gabebuckmaster/Si4825-AM-FM-Radio-Kit-SMT/README.md

# Si4825-AM-FM-Radio-Kit-SMT
Si4825 AM/FM Radio Kit (SMT)
