gabebuckmaster/Si4825-AM-FM-Radio-Kit-SMT/Si4825_KIT_SMT_pcb_preview_top.png

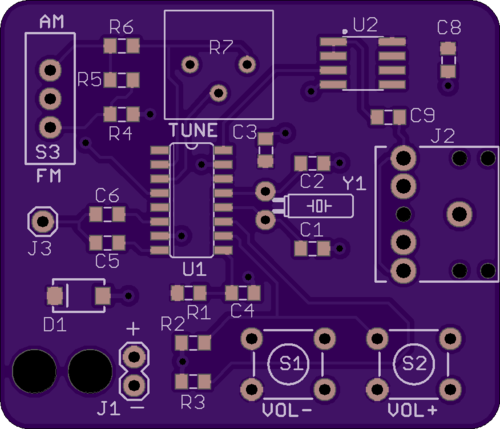
Si4825_KIT_SMT_pcb_preview_top.png
