gabebuckmaster/Si4825-AM-FM-Radio-Kit-SMT/SI4825_KIT_SMT_BOM.xlsx

Ref Des | Description | Manufacturer | MPN | Qty | Price at Qty*20 | Link | Alternate
C1, C2 | 22pF 0805 C0G Capacitor | Kemet | C0805C220J5GACTU | 2 | 0.048 | http://www.digikey.com/product-detail/en/kemet/C0805C220J5GACTU/399-1113-1-ND/411388
C3-C6, C8 | 1uF 0805 X7R Capacitor | Yageo | CC0805KKX7R7BB105 | 5 | 0.069 | http://www.digikey.com/product-detail/en/yageo/CC0805KKX7R7BB105/311-1365-1-ND/2103149
C9 | 22uF 0805 X6S Capacitor | Murata | GRM21BC80G226ME39L | 1 | 0.14 | http://www.digikey.com/product-detail/en/murata-electronics-north-america/GRM21BC80G226ME39L/490-6464-1-ND/3845661
D1 | 1A SMA General Purpose Diode | Diodes Incorporated | S1A-13-F | 1 | 0.199 | http://www.digikey.com/product-detail/en/diodes-incorporated/S1A-13-F/S1A-FDICT-ND/750031
J1 | Connection point for battery pack |  |  | 0
J2 | Headphone Jack | CUI Inc | SJ1-3523NG | 1 | 0.808 | http://www.digikey.com/product-search/en?keywords=SJ1-3523NG
J3 | Antenna connection point |  |  | 0
R1-R3 | 100kOhm 1% 0805 Resistor | Any |  | 3 | 0.0084 | http://www.digikey.com/product-detail/en/yageo/RC0805FR-07100KL/311-100KCRCT-ND/730491
R4 | 76.8kOhm 1% 0805 Resistor | Any |  | 1 | 0.021 | http://www.digikey.com/product-detail/en/yageo/RC0805FR-0776K8L/311-76.8KCRCT-ND/731084
R5 | 150kOhm 1% 0805 Resistor | Any |  | 1 | 0.021 | http://www.digikey.com/product-detail/en/yageo/RC0805FR-07150KL/311-150KCRCT-ND/730561
R6 | 273kOhm 1% 0805 Resistor | Any |  | 1 | 0.021 | http://www.digikey.com/product-detail/en/yageo/RC0805FR-07274KL/311-274KCRCT-ND/730733
R7 | 100kOhm Potentiometer | Bourns | 3386P-1-104TLF | 1 | 2.175 | http://www.digikey.com/product-search/en?keywords=3386P-1-104TLF
R8 | 0805 Jumper | Any |  | NOSTUFF | 0.018 | http://www.digikey.com/product-detail/en/yageo/RC0805JR-070RL/311-0.0ARCT-ND/731163
S1, S2 | Momentary Pushbutton Switch - NO | TE Connectivity | 1825910-6 | 2 | 0.088 | http://www.digikey.com/product-detail/en/te-connectivity-alcoswitch-switches/1825910-6/450-1650-ND/1632536
S3 | SPDT switch | E-Switch | EG1218 | 1 | 0.559 | http://www.digikey.com/product-detail/en/e-switch/EG1218/EG1903-ND/101726
U1 | Multi-band Radio Receiver IC | SiLabs | SI4825-A10-CS | 1 | ? | ?
U2 | Dual low-voltage op amp | Microchip | MCP6002T-I/SN | 1 | 0.33 | http://www.digikey.com/product-detail/en/microchip-technology/MCP6002T-I-SN/MCP6002T-I-SNDKR-ND/4307917
Y1 | 32.768 kHz Crystal (cylindrical can, radial) | Citizen Finedevice Co Ltd | CFS-20632768DZBB | 1 | 0.2 | http://www.digikey.com/product-detail/en/citizen-finedevice-co-ltd/CFS-20632768DZBB/300-8301-ND/862578
XX | Battery holder with switch | Memory Protection Devices | SBH321AS | 1 | 2.14 | http://www.digikey.com/product-detail/en/mpd-memory-protection-devices/SBH321AS/SBH321AS-ND/275301 | http://www.digikey.com/product-search/en?keywords=SBH421AS-ND
XX | SI4825 Surface Mount KIT PCB
