gabebuckmaster/Si4825-AM-FM-Radio-Kit-SMT/Si4825_KIT_SMT_schematic.pdf

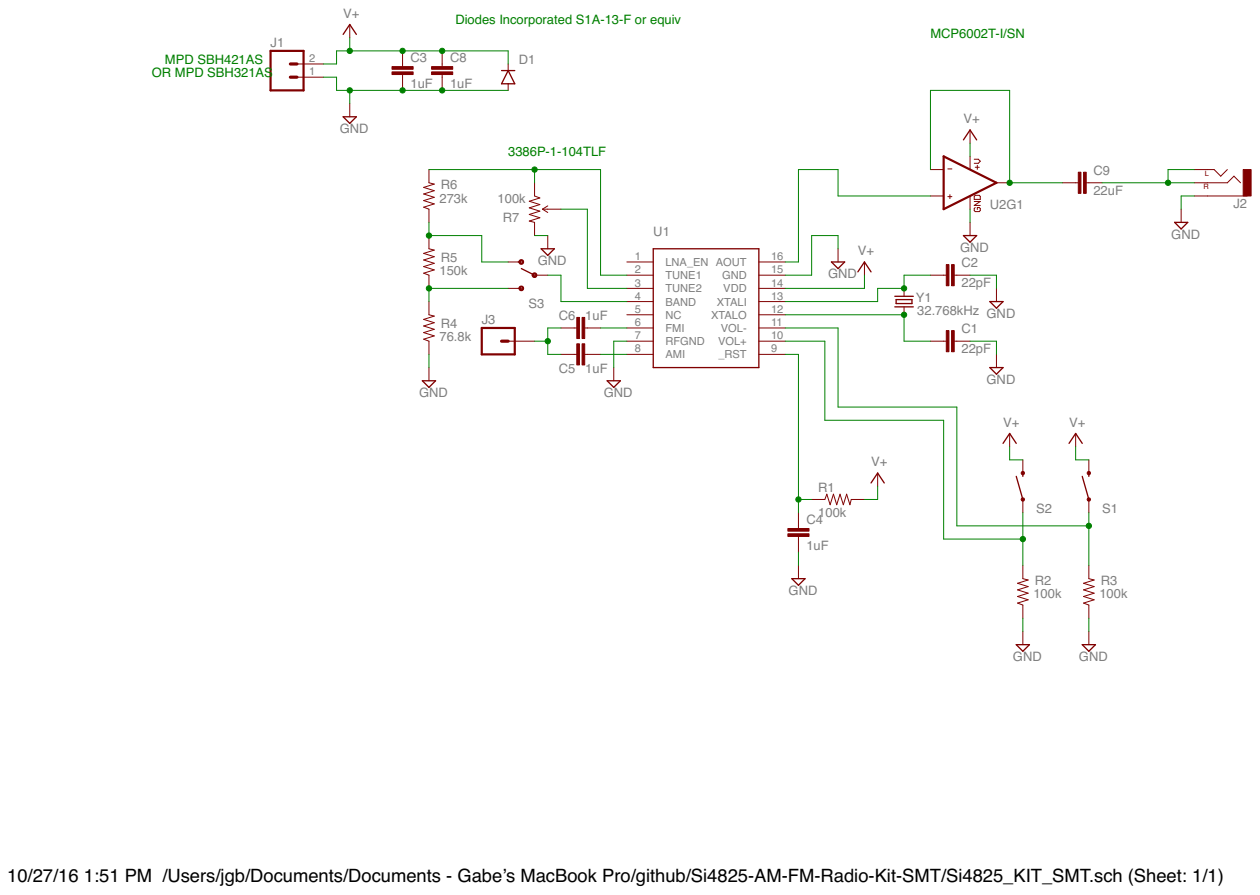
[picture p3: page 1]

10/27/16 1:51 PM /Users/jgb/Documents/Documents - Gabe’s MacBook Pro/github/Si4825-AM-FM-Radio-Kit-SMT/Si4825_KIT_SMT.sch (Sheet: 1/1)
