gabebuckmaster/Si4825-AM-FM-Radio-Kit-SMT/(commit log)

2016-09-21 Added initial design
    [SI4825_KIT_SMT_BOM.xlsx, Si4825_KIT_SMT.brd, Si4825_KIT_SMT.sch]
2016-10-27 Fixed issues discovered in first build
    - fixed potentiometer footprint
    - bigger strain relief holes: .1” to .15”
    - changed value of C9 (AC coupling capacitor) to 22uF in BOM and
    schematic
    - Removed R8 (jumper to bypass op amp)
    - Increased length of surface mount pads for 0805 components to
    facilitate hand soldering
    - Regenerated gerbers, jpg previews, and pdf of schematic
    [SI4825_KIT_SMT_BOM.xlsx, Si4825_KIT_SMT.brd, Si4825_KIT_SMT.sch]
